DanNixon/pico-plc/README.md

# Pico-PLC

A [Raspberry Pi Pico](https://www.raspberrypi.com/products/raspberry-pi-pico/) powered PLC like general purpose control board.

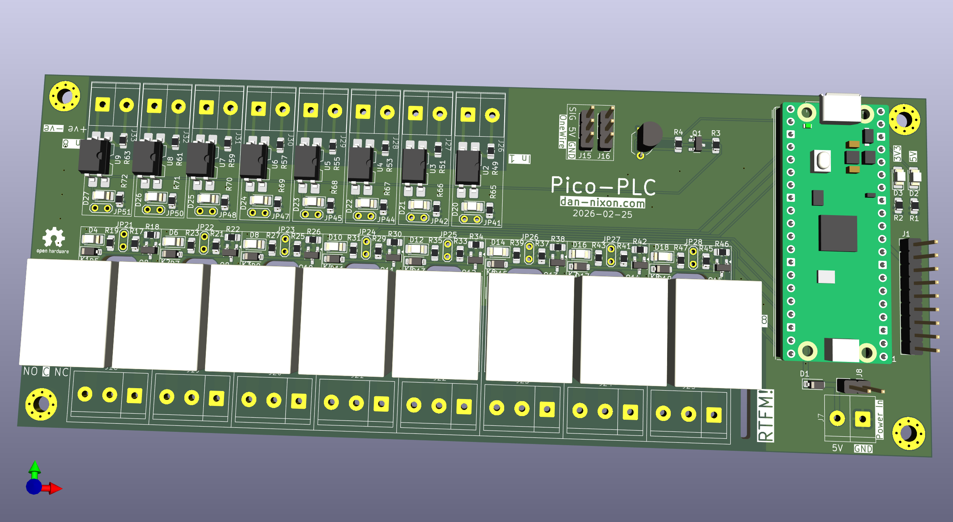
[picture p1: docs/board-render.png]
Pico-PLC PCB
