DanNixon/pico-plc/pcb/README.md

# Pico-PLC PCB

[KiCad](https://www.kicad.org/) flavoured design files for the Pico-PLC PCB.
