DanNixon/pico-plc/pcb/pico-plc.kicad_pcb

## KiCad design pcb/pico-plc.kicad_pcb (2026-03-20)

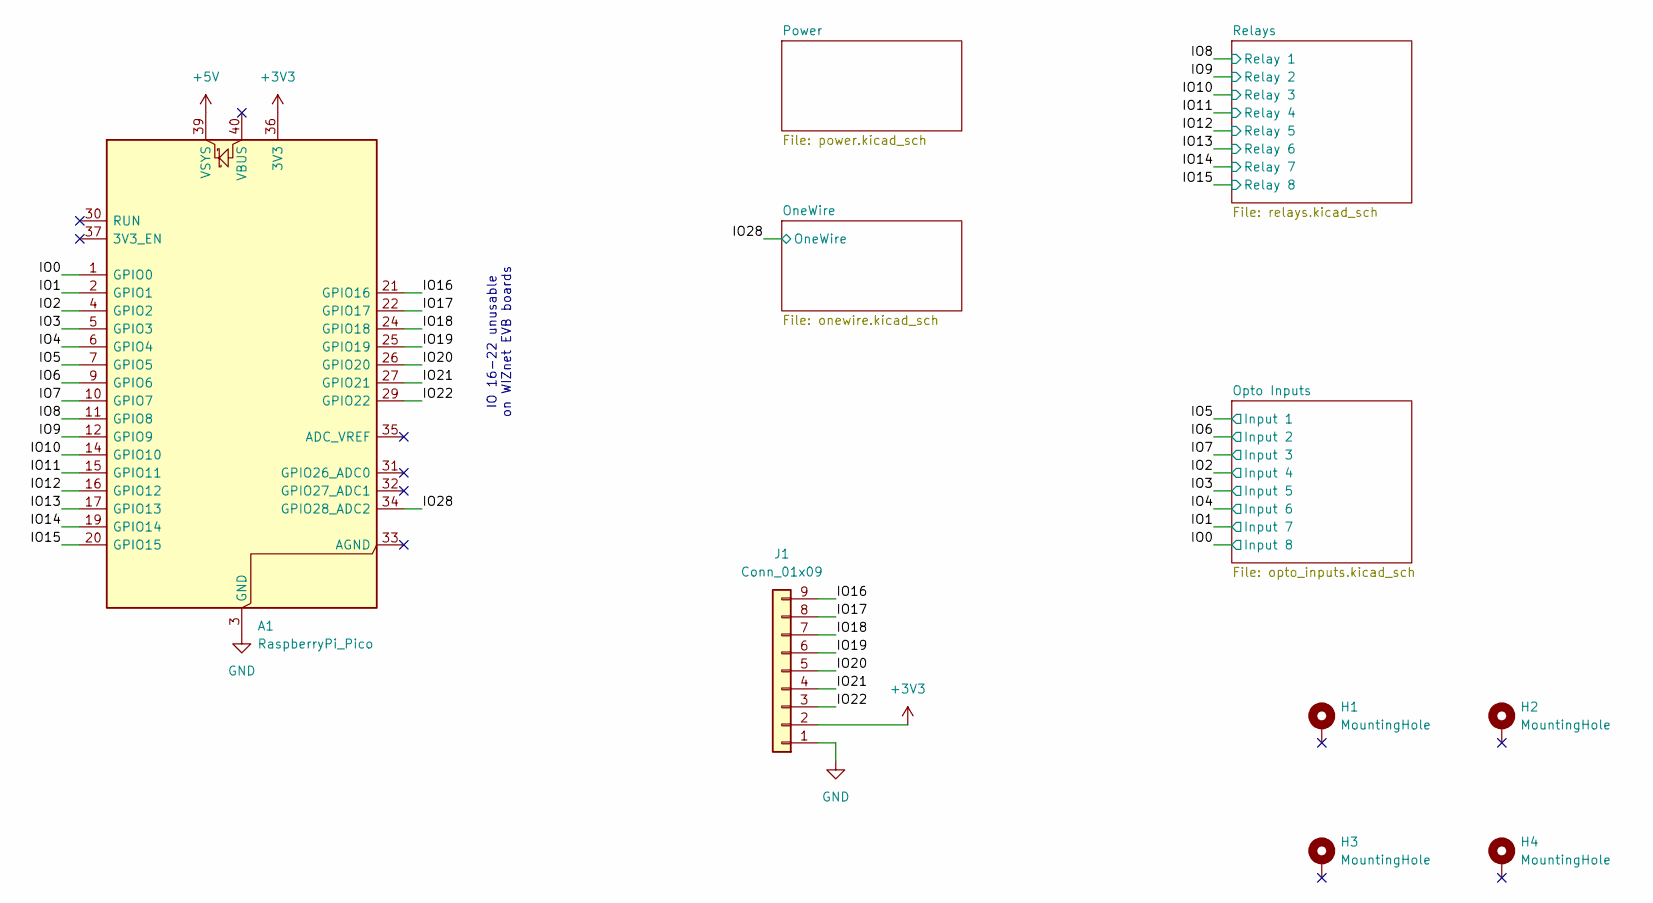
[picture p2: schematic pico-plc.kicad_sch]

Parts:
A1: RaspberryPi_Pico; RaspberryPi_Pico_Common_THT
H1, H2, H3, H4: MountingHole; MountingHole_3.2mm_M3_Pad_Via
J1: Conn_01x09; PinHeader_1x09_P2.54mm_Vertical

Connections:
+3V3: A1.36 (3V3), J1.2; also elsewhere on the board
+5V: A1.39 (VSYS); also elsewhere on the board
/IO0: A1.1 (GPIO0); also elsewhere on the board
/IO1: A1.2 (GPIO1); also elsewhere on the board
/IO2: A1.4 (GPIO2); also elsewhere on the board
/IO3: A1.5 (GPIO3); also elsewhere on the board
/IO4: A1.6 (GPIO4); also elsewhere on the board
/IO5: A1.7 (GPIO5); also elsewhere on the board
/IO6: A1.9 (GPIO6); also elsewhere on the board
/IO7: A1.10 (GPIO7); also elsewhere on the board
/IO8: A1.11 (GPIO8); also elsewhere on the board
/IO9: A1.12 (GPIO9); also elsewhere on the board
/IO10: A1.14 (GPIO10); also elsewhere on the board
/IO11: A1.15 (GPIO11); also elsewhere on the board
/IO12: A1.16 (GPIO12); also elsewhere on the board
/IO13: A1.17 (GPIO13); also elsewhere on the board
/IO14: A1.19 (GPIO14); also elsewhere on the board
/IO15: A1.20 (GPIO15); also elsewhere on the board
/IO16: A1.21 (GPIO16), J1.9
/IO17: A1.22 (GPIO17), J1.8
/IO18: A1.24 (GPIO18), J1.7
/IO19: A1.25 (GPIO19), J1.6
/IO20: A1.26 (GPIO20), J1.5
/IO21: A1.27 (GPIO21), J1.4
/IO22: A1.29 (GPIO22), J1.3
/IO28: A1.34 (GPIO28_ADC2); also elsewhere on the board
GND: A1.3 (GND), A1.8 (GND), A1.13 (GND), A1.18 (GND), A1.23 (GND), A1.28 (GND), A1.38 (GND), J1.1; also elsewhere on the board

Notes on the sheet:
IO 16-22 unusable on WIZnet EVB boards

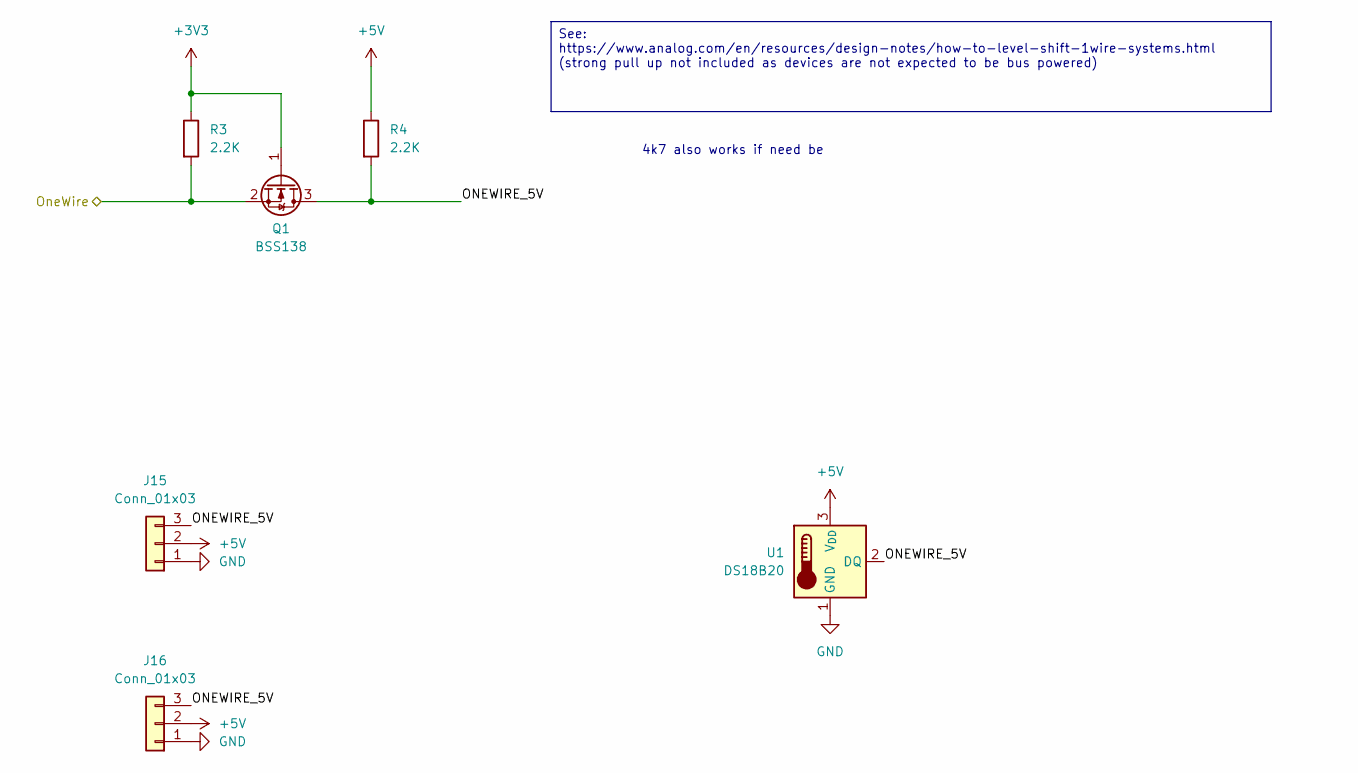
[picture p3: schematic onewire.kicad_sch]

Parts:
J15, J16: Conn_01x03; PinHeader_1x03_P2.54mm_Vertical
Q1: BSS138; SOT-23
R3, R4: 2.2K; R_0805_2012Metric_Pad1.20x1.40mm_HandSolder
U1: DS18B20; TO-92_Inline_Wide

Connections:
+3V3: Q1.1 (G), R3.1; also elsewhere on the board
+5V: J15.2, J16.2, R4.1, U1.3 (V_{DD}); also elsewhere on the board
/IO28: Q1.2 (S), R3.2; also elsewhere on the board
/OneWire/ONEWIRE_5V: J15.3, J16.3, Q1.3 (D), R4.2, U1.2 (DQ)
GND: J15.1, J16.1, U1.1 (GND); also elsewhere on the board

Notes on the sheet:
4k7 also works if need be
See: https://www.analog.com/en/resources/design-notes/how-to-level-shift-1wire-systems.html (strong pull up not included as devices are not expected to be bus powered)

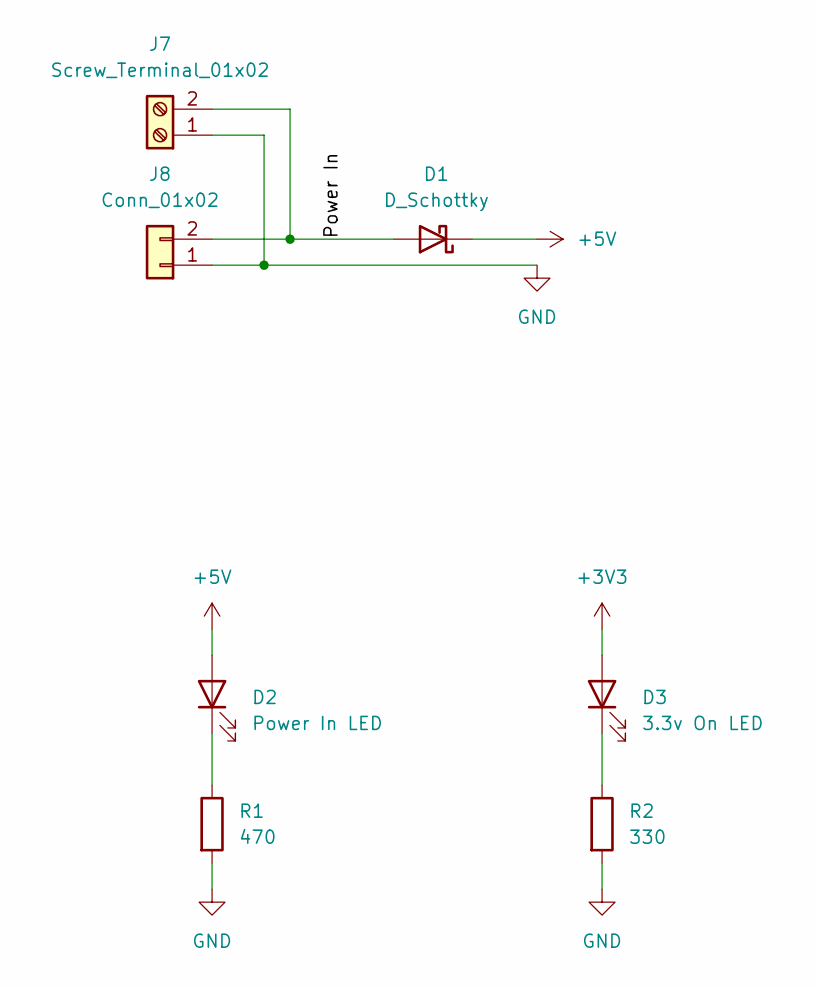
[picture p4: schematic power.kicad_sch]

Parts:
D1: D_Schottky; D_SOD-123
D2: Power In LED; LED_1206_3216Metric_Pad1.42x1.75mm_HandSolder
D3: 3.3v On LED; LED_1206_3216Metric_Pad1.42x1.75mm_HandSolder
J7: Screw_Terminal_01x02; CTB7000-2
J8: Conn_01x02; PinHeader_1x02_P2.54mm_Vertical
R1: 470; R_0805_2012Metric_Pad1.20x1.40mm_HandSolder
R2: 330; R_0805_2012Metric_Pad1.20x1.40mm_HandSolder

Connections:
+3V3: D3.2 (A); also elsewhere on the board
+5V: D1.1 (K), D2.2 (A); also elsewhere on the board
/Power/Power In: D1.2 (A), J7.2, J8.2
GND: J7.1, J8.1, R1.2, R2.2; also elsewhere on the board
unnamed: D2.1 (K), R1.1
unnamed: D3.1 (K), R2.1

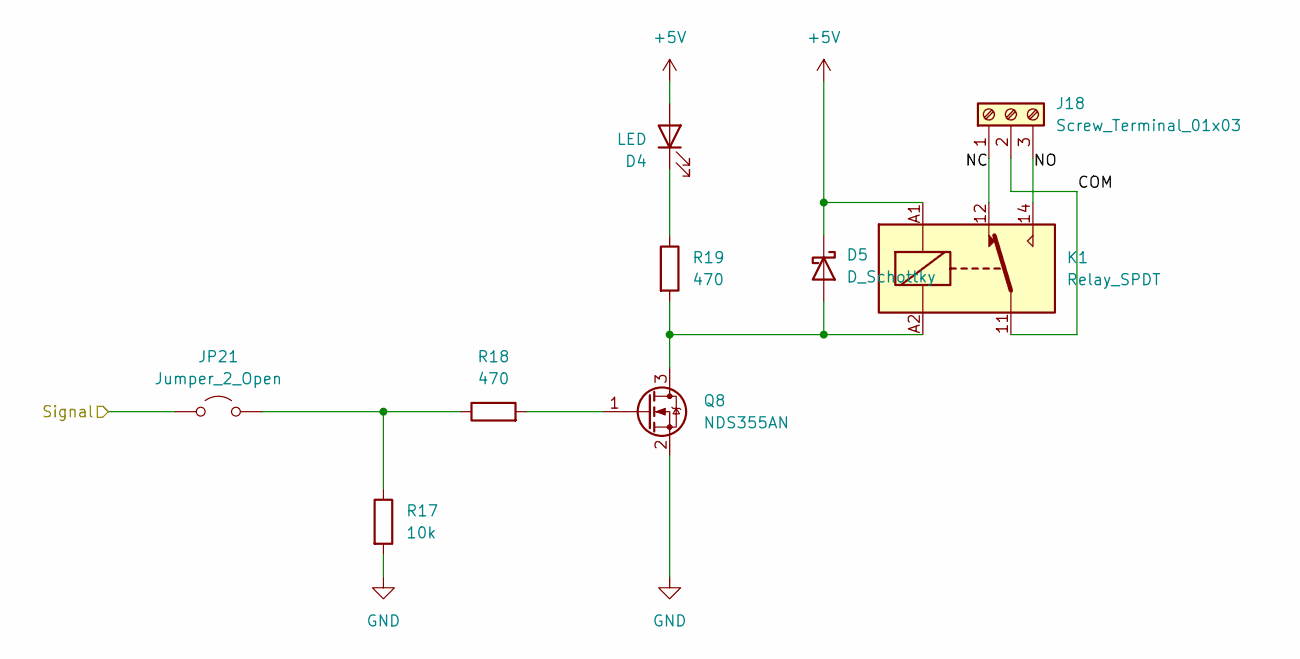
[picture p5: schematic relay_output.kicad_sch]

Parts:
D4: LED; LED_1206_3216Metric_Pad1.42x1.75mm_HandSolder
D5: D_Schottky; D_SOD-123
J18: Screw_Terminal_01x03; CTB7000-3
JP21: Jumper_2_Open; TestPoint_2Pads_Pitch2.54mm_Drill0.8mm
K1: Relay_SPDT; Relay_SPDT_Finder_36.11
Q8: NDS355AN; SOT-23-3
R17: 10k; R_0805_2012Metric_Pad1.20x1.40mm_HandSolder
R18, R19: 470; R_0805_2012Metric_Pad1.20x1.40mm_HandSolder

Connections:
+5V: D4.2 (A), D5.1 (K), K1.A1; also elsewhere on the board
/IO8: JP21.1 (A); also elsewhere on the board
/Relays/Relay 0/COM: J18.2, K1.11
/Relays/Relay 0/NC: J18.1, K1.12
/Relays/Relay 0/NO: J18.3, K1.14
GND: Q8.2 (S), R17.2; also elsewhere on the board
unnamed: D4.1 (K), R19.1
unnamed: D5.2 (A), K1.A2, Q8.3 (D), R19.2
unnamed: JP21.2 (B), R17.1, R18.1
unnamed: Q8.1 (G), R18.2

Parts of its further copies:
D6, D8, D10, D12, D14, D16, D18: LED; LED_1206_3216Metric_Pad1.42x1.75mm_HandSolder
D7, D9, D11, D13, D15, D17, D19: D_Schottky; D_SOD-123
J19, J20, J21, J22, J23, J24, J25: Screw_Terminal_01x03; CTB7000-3
JP22, JP23, JP24, JP25, JP26, JP27, JP28: Jumper_2_Open; TestPoint_2Pads_Pitch2.54mm_Drill0.8mm
K2, K3, K4, K5, K6, K7, K8: Relay_SPDT; Relay_SPDT_Finder_36.11
Q9, Q10, Q11, Q12, Q13, Q14, Q15: NDS355AN; SOT-23-3
R21, R25, R29, R33, R37, R41, R45: 10k; R_0805_2012Metric_Pad1.20x1.40mm_HandSolder
R22, R23, R26, R27, R30, R31, R34, R35, R38, R39, R42, R43, R46, R47: 470; R_0805_2012Metric_Pad1.20x1.40mm_HandSolder

Connections of its further copies:
+5V: D6.2 (A), D7.1 (K), D8.2 (A), D9.1 (K), D10.2 (A), D11.1 (K), D12.2 (A), D13.1 (K), D14.2 (A), D15.1 (K), D16.2 (A), D17.1 (K), D18.2 (A), D19.1 (K), K2.A1, K3.A1, K4.A1, K5.A1, K6.A1, K7.A1, K8.A1; also elsewhere on the board
/IO9: JP22.1 (A); also elsewhere on the board
/IO10: JP23.1 (A); also elsewhere on the board
/IO11: JP24.1 (A); also elsewhere on the board
/IO12: JP25.1 (A); also elsewhere on the board
/IO13: JP26.1 (A); also elsewhere on the board
/IO14: JP27.1 (A); also elsewhere on the board
/IO15: JP28.1 (A); also elsewhere on the board
/Relays/Relay 1/COM: J19.2, K2.11
/Relays/Relay 1/NC: J19.1, K2.12
/Relays/Relay 1/NO: J19.3, K2.14
/Relays/Relay 2/COM: J20.2, K3.11
/Relays/Relay 2/NC: J20.1, K3.12
/Relays/Relay 2/NO: J20.3, K3.14
/Relays/Relay 3/COM: J21.2, K4.11
/Relays/Relay 3/NC: J21.1, K4.12
/Relays/Relay 3/NO: J21.3, K4.14
/Relays/Relay 4/COM: J22.2, K5.11
/Relays/Relay 4/NC: J22.1, K5.12
/Relays/Relay 4/NO: J22.3, K5.14
/Relays/Relay 5/COM: J23.2, K6.11
/Relays/Relay 5/NC: J23.1, K6.12
/Relays/Relay 5/NO: J23.3, K6.14
/Relays/Relay 6/COM: J24.2, K7.11
/Relays/Relay 6/NC: J24.1, K7.12
/Relays/Relay 6/NO: J24.3, K7.14
/Relays/Relay 7/COM: J25.2, K8.11
/Relays/Relay 7/NC: J25.1, K8.12
/Relays/Relay 7/NO: J25.3, K8.14
GND: Q9.2 (S), Q10.2 (S), Q11.2 (S), Q12.2 (S), Q13.2 (S), Q14.2 (S), Q15.2 (S), R21.2, R25.2, R29.2, R33.2, R37.2, R41.2, R45.2; also elsewhere on the board
unnamed: D6.1 (K), R23.1
unnamed: D7.2 (A), K2.A2, Q9.3 (D), R23.2
unnamed: D8.1 (K), R27.1
unnamed: D9.2 (A), K3.A2, Q10.3 (D), R27.2
unnamed: D10.1 (K), R31.1
unnamed: D11.2 (A), K4.A2, Q11.3 (D), R31.2
unnamed: D12.1 (K), R35.1
unnamed: D13.2 (A), K5.A2, Q12.3 (D), R35.2
unnamed: D14.1 (K), R39.1
unnamed: D15.2 (A), K6.A2, Q13.3 (D), R39.2
unnamed: D16.1 (K), R43.1
unnamed: D17.2 (A), K7.A2, Q14.3 (D), R43.2
unnamed: D18.1 (K), R47.1
unnamed: D19.2 (A), K8.A2, Q15.3 (D), R47.2
unnamed: JP22.2 (B), R21.1, R22.1
unnamed: JP23.2 (B), R25.1, R26.1
unnamed: JP24.2 (B), R29.1, R30.1
unnamed: JP25.2 (B), R33.1, R34.1
unnamed: JP26.2 (B), R37.1, R38.1
unnamed: JP27.2 (B), R41.1, R42.1
unnamed: JP28.2 (B), R45.1, R46.1
unnamed: Q9.1 (G), R22.2
unnamed: Q10.1 (G), R26.2
unnamed: Q11.1 (G), R30.2
unnamed: Q12.1 (G), R34.2
unnamed: Q13.1 (G), R38.2
unnamed: Q14.1 (G), R42.2
unnamed: Q15.1 (G), R46.2

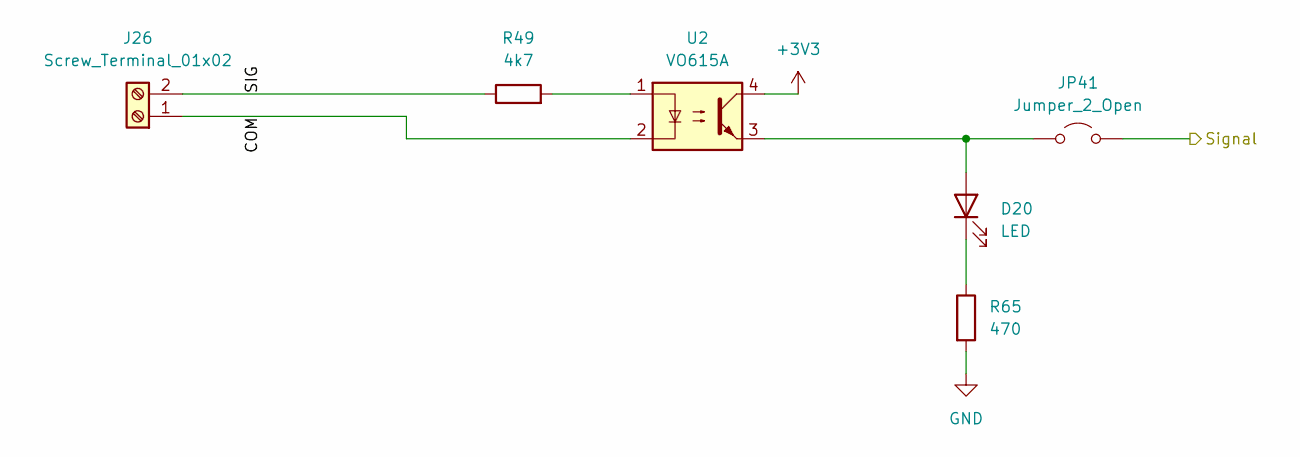
[picture p6: schematic opto_input.kicad_sch]

Parts:
D20: LED; LED_1206_3216Metric_Pad1.42x1.75mm_HandSolder
J26: Screw_Terminal_01x02; CTB7000-2
JP41: Jumper_2_Open; TestPoint_2Pads_Pitch2.54mm_Drill0.8mm
R49: 4k7; R_0805_2012Metric_Pad1.20x1.40mm_HandSolder
R65: 470; R_0805_2012Metric_Pad1.20x1.40mm_HandSolder
U2: VO615A; SMDIP-4_W9.53mm

Connections:
+3V3: U2.4; also elsewhere on the board
/IO5: JP41.2 (B); also elsewhere on the board
/Opto Inputs/Input 0/COM: J26.1, U2.2
/Opto Inputs/Input 0/SIG: J26.2, R49.1
GND: R65.2; also elsewhere on the board
unnamed: D20.2 (A), JP41.1 (A), U2.3
unnamed: D20.1 (K), R65.1
unnamed: R49.2, U2.1

Parts of its further copies:
D21, D22, D23, D24, D25, D26, D27: LED; LED_1206_3216Metric_Pad1.42x1.75mm_HandSolder
J27, J28, J29, J30, J31, J32, J33: Screw_Terminal_01x02; CTB7000-2
JP42, JP44, JP45, JP47, JP48, JP50, JP51: Jumper_2_Open; TestPoint_2Pads_Pitch2.54mm_Drill0.8mm
R51, R53, R55, R57, R59, R61, R63: 4k7; R_0805_2012Metric_Pad1.20x1.40mm_HandSolder
R66, R67, R68, R69, R70, R71, R72: 470; R_0805_2012Metric_Pad1.20x1.40mm_HandSolder
U3, U4, U5, U6, U7, U8, U9: VO615A; SMDIP-4_W9.53mm

Connections of its further copies:
+3V3: U3.4, U4.4, U5.4, U6.4, U7.4, U8.4, U9.4; also elsewhere on the board
/IO0: JP51.2 (B); also elsewhere on the board
/IO1: JP50.2 (B); also elsewhere on the board
/IO2: JP45.2 (B); also elsewhere on the board
/IO3: JP47.2 (B); also elsewhere on the board
/IO4: JP48.2 (B); also elsewhere on the board
/IO6: JP42.2 (B); also elsewhere on the board
/IO7: JP44.2 (B); also elsewhere on the board
/Opto Inputs/Input 1/COM: J27.1, U3.2
/Opto Inputs/Input 1/SIG: J27.2, R51.1
/Opto Inputs/Input 2/COM: J28.1, U4.2
/Opto Inputs/Input 2/SIG: J28.2, R53.1
/Opto Inputs/Input 3/COM: J29.1, U5.2
/Opto Inputs/Input 3/SIG: J29.2, R55.1
/Opto Inputs/Input 4/COM: J30.1, U6.2
/Opto Inputs/Input 4/SIG: J30.2, R57.1
/Opto Inputs/Input 5/COM: J31.1, U7.2
/Opto Inputs/Input 5/SIG: J31.2, R59.1
/Opto Inputs/Input 6/COM: J32.1, U8.2
/Opto Inputs/Input 6/SIG: J32.2, R61.1
/Opto Inputs/Input 7/COM: J33.1, U9.2
/Opto Inputs/Input 7/SIG: J33.2, R63.1
GND: R66.2, R67.2, R68.2, R69.2, R70.2, R71.2, R72.2; also elsewhere on the board
unnamed: D21.2 (A), JP42.1 (A), U3.3
unnamed: D21.1 (K), R66.1
unnamed: D22.2 (A), JP44.1 (A), U4.3
unnamed: D22.1 (K), R67.1
unnamed: D23.2 (A), JP45.1 (A), U5.3
unnamed: D23.1 (K), R68.1
unnamed: D24.2 (A), JP47.1 (A), U6.3
unnamed: D24.1 (K), R69.1
unnamed: D25.2 (A), JP48.1 (A), U7.3
unnamed: D25.1 (K), R70.1
unnamed: D26.2 (A), JP50.1 (A), U8.3
unnamed: D26.1 (K), R71.1
unnamed: D27.2 (A), JP51.1 (A), U9.3
unnamed: D27.1 (K), R72.1
unnamed: R51.2, U3.1
unnamed: R53.2, U4.1
unnamed: R55.2, U5.1
unnamed: R57.2, U6.1
unnamed: R59.2, U7.1
unnamed: R61.2, U8.1
unnamed: R63.2, U9.1

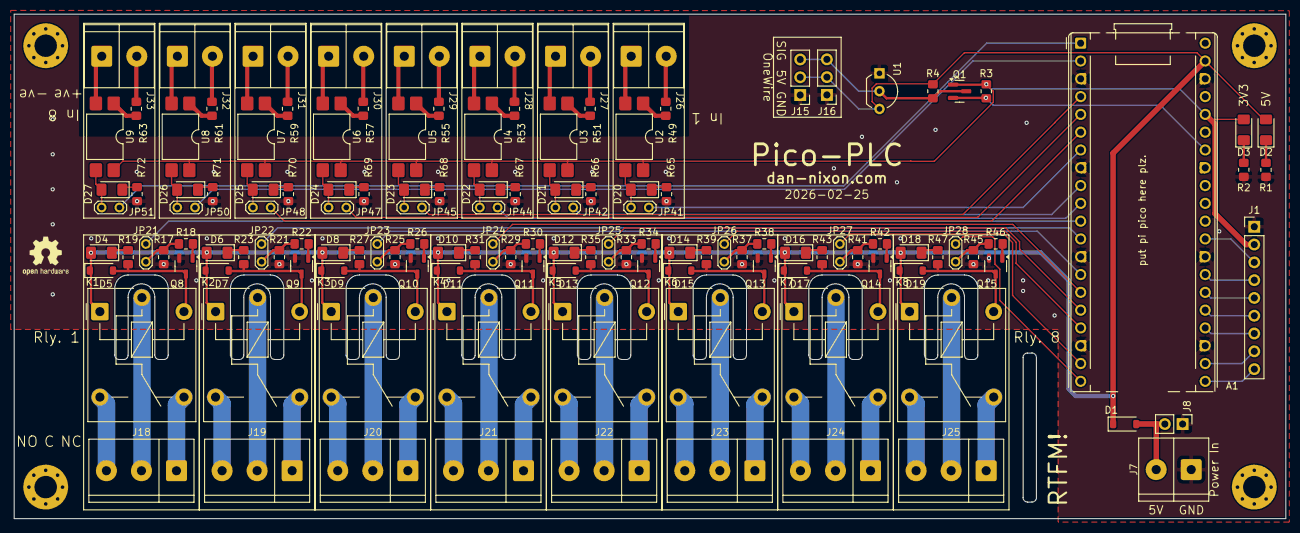
[picture p7: board pico-plc.kicad_pcb from above]

Board: 2 copper layers, 181.5 x 72.0 mm, 139 parts (0 on the bottom side), 127 nets.
