DanNixon/pico-plc/(commit log)

2025-02-12 Switch to devenv
2025-02-28 Use larger screw terminals, adjust layout to suit
    [configurable_level_shifter.kicad_sch, general_io.kicad_sch, onewire.kicad_sch, opto_input.kicad_sch, opto_inputs.kicad_sch, pico-plc.kicad_pcb, pico-plc.kicad_sch, power.kicad_sch]
2025-03-01 Convert PCB to KiCad 9 project
    [configurable_level_shifter.kicad_sch, general_io.kicad_sch, onewire.kicad_sch, opto_input.kicad_sch, opto_inputs.kicad_sch, pico-plc.kicad_pcb, pico-plc.kicad_sch, power.kicad_sch]
2025-03-01 Rerun DRC after KiCad 9 conversion
    [pico-plc.kicad_pcb]
2025-03-01 Update component properties and rerun ERC
    [configurable_level_shifter.kicad_sch, opto_input.kicad_sch, pico-plc.kicad_pcb, relay_output.kicad_sch]
2025-03-04 pcb: disconnect mounting holes from GND, fix dimension annotations
    [pico-plc.kicad_pcb, pico-plc.kicad_sch]
2025-03-13 Add board support package/crate
    - Adds board support crate (heavily inspired by https://github.com/lulf/microbit-bsp)
    - Move demo firmware to an example
2025-04-09 bsp: pico 2 support
2025-07-03 build(deps): bump the cargo-dependencies group across 1 directory with 3 updates
    Updates the requirements on [defmt](https://github.com/knurling-rs/defmt), [defmt-rtt](https://github.com/knurling-rs/defmt) and [panic-probe](https://github.com/knurling-rs/defmt) to permit the latest version.
    Updates `defmt` to 1.0.1
    - [Release notes](https://github.com/knurling-rs/defmt/releases)
    - [Changelog](https://github.com/knurling-rs/defmt/blob/main/CHANGELOG.md)
    - [Commits](https://github.com/knurling-rs/defmt/compare/defmt-v0.3.10...defmt-v1.0.1)
    Updates `defmt-rtt` to 1.0.0
    - [Release notes](https://github.com/knurling-rs/defmt/releases)
    - [Changelog](https://github.com/knurling-rs/defmt/blob/main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
2025-07-03 build(deps): bump the cargo-dependencies group across 1 directory with 3 updates
    ---
    updated-dependencies:
    - dependency-name: defmt
    dependency-version: 1.0.1
    dependency-type: direct:production
    dependency-group: cargo-dependencies
    - dependency-name: defmt-rtt
    dependency-version: 1.0.0
    dependency-type: direct:production
    dependency-group: cargo-dependencies
    - dependency-name: panic-probe
    dependency-version: 1.0.0
    dependency-type: direct:production
    dependency-group: cargo-dependencies
    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
2025-07-23 Use probe-rs from stable
2026-01-16 Switch to Nix flake, add typos
2026-02-26 Add case
    [YAPPgenerator_v3.scad, case.scad]
2026-02-26 Simpler bottom mount case
    [YAPPgenerator_v3.scad, case.scad]
2026-03-20 New board revision
    [case.scad, configurable_level_shifter.kicad_sch, general_io.kicad_sch, opto_input.kicad_sch, pico-plc.kicad_pcb, pico-plc.kicad_sch, power.kicad_sch]
